matiasmicheletto/CompostGrid/Datasheets/ArduinoUNO.png

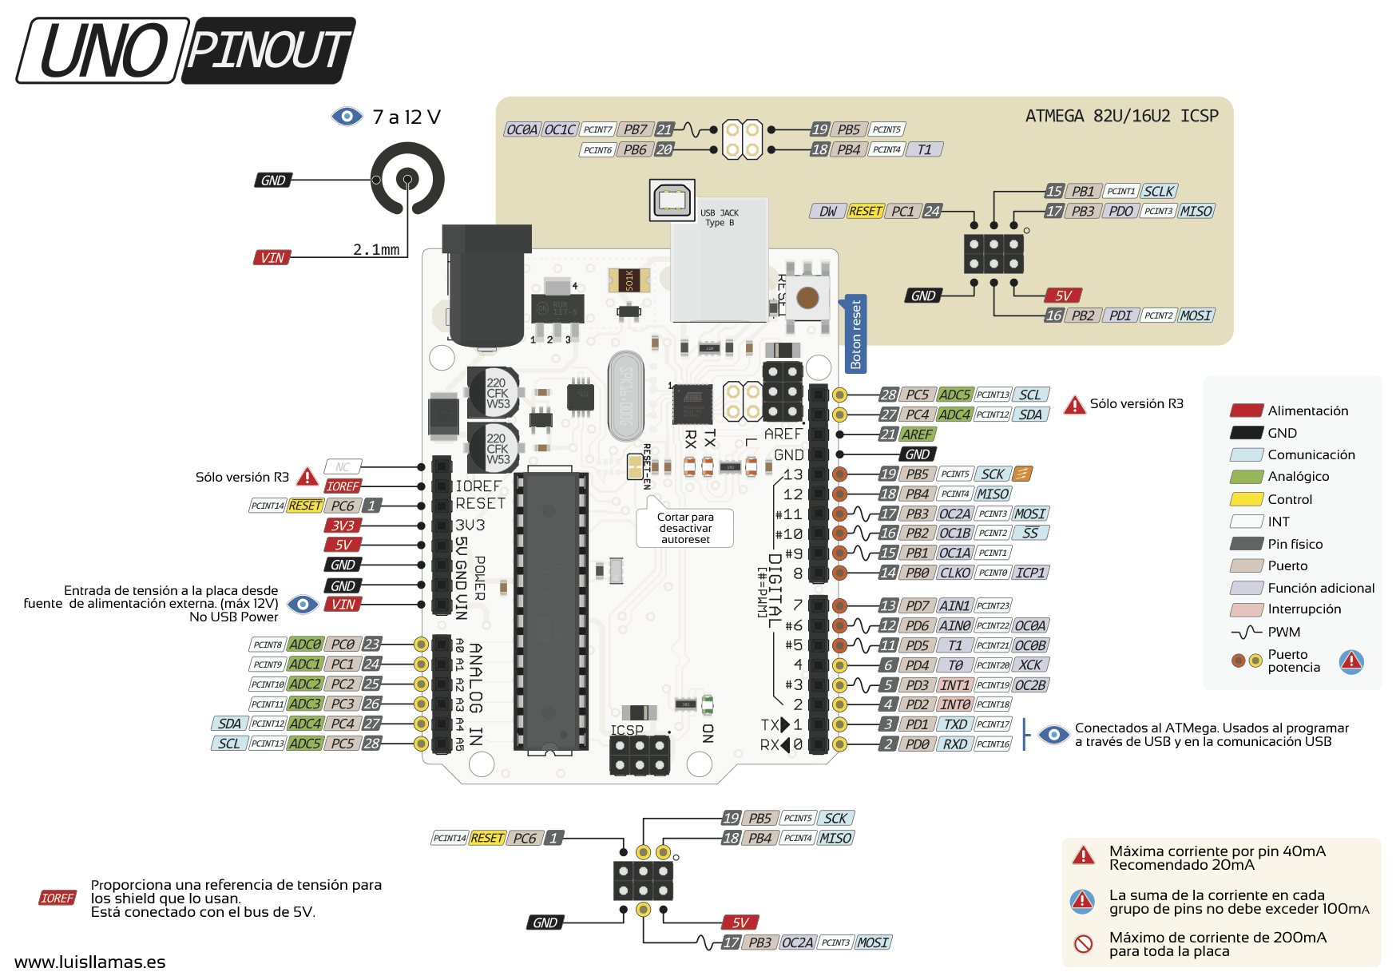
Datasheets/ArduinoUNO.png
