matiasmicheletto/CompostGrid/Hardware/Shield3D.png

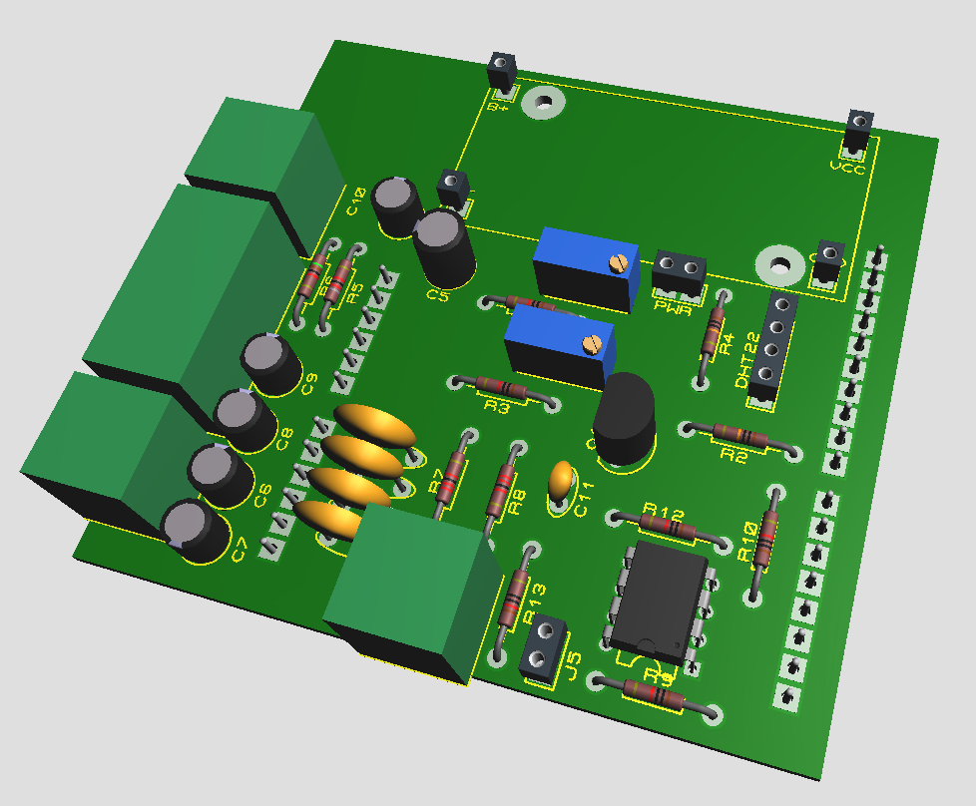
Hardware/Shield3D.png
