matiasmicheletto/CompostGrid/Hardware/Shield.BMP

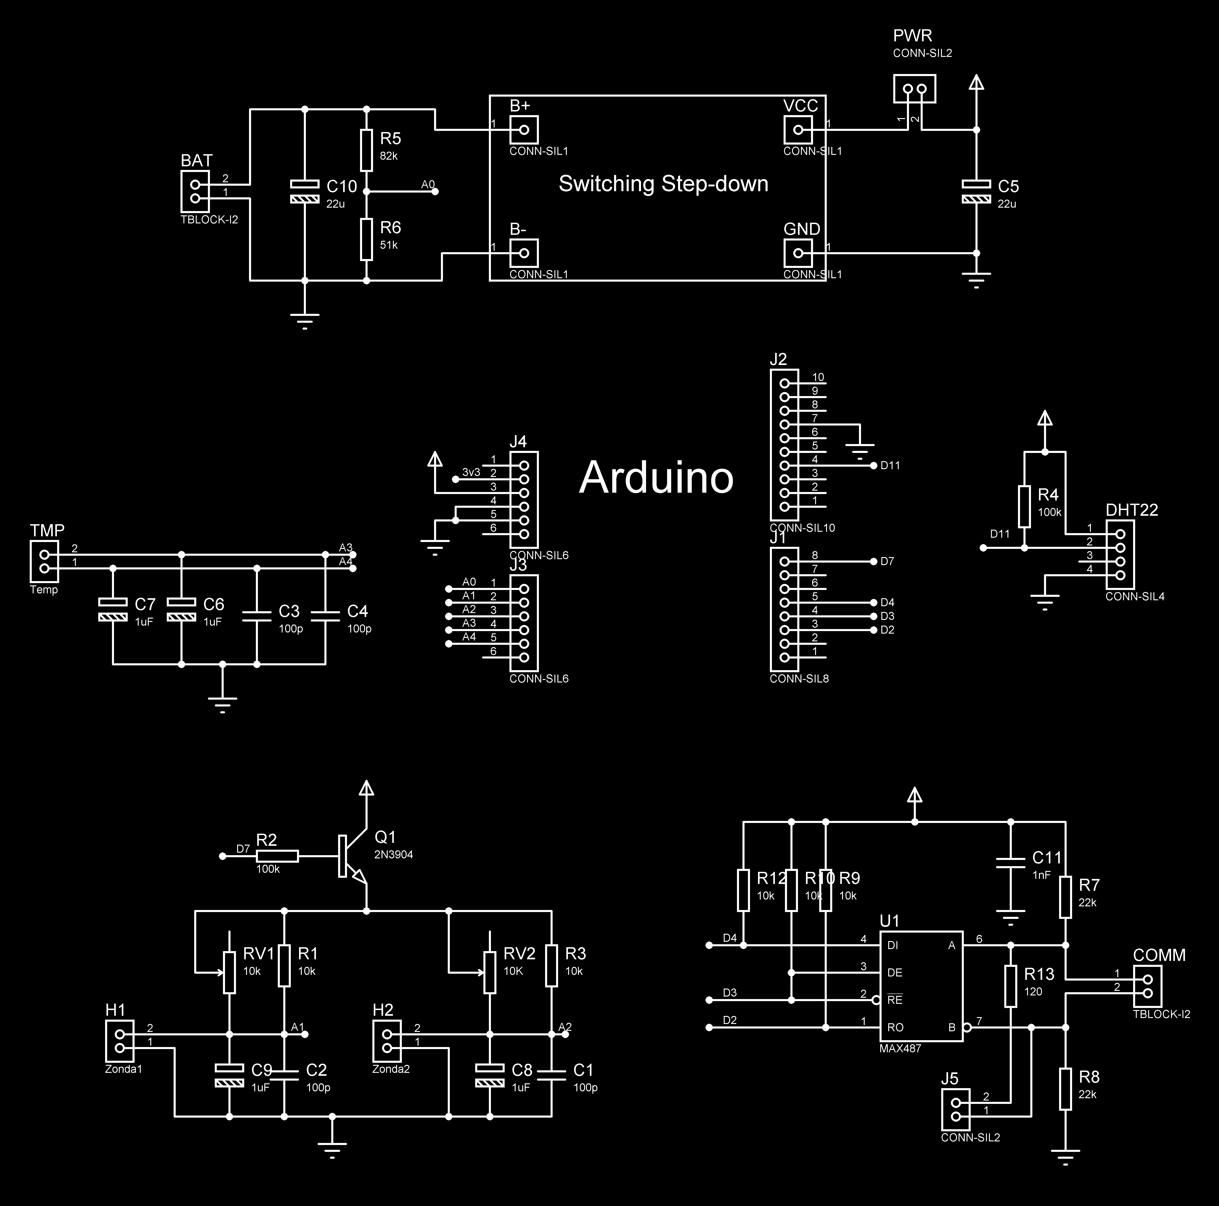
Hardware/Shield.BMP
