matiasmicheletto/CompostGrid/Hardware/Shield_PCB.BMP

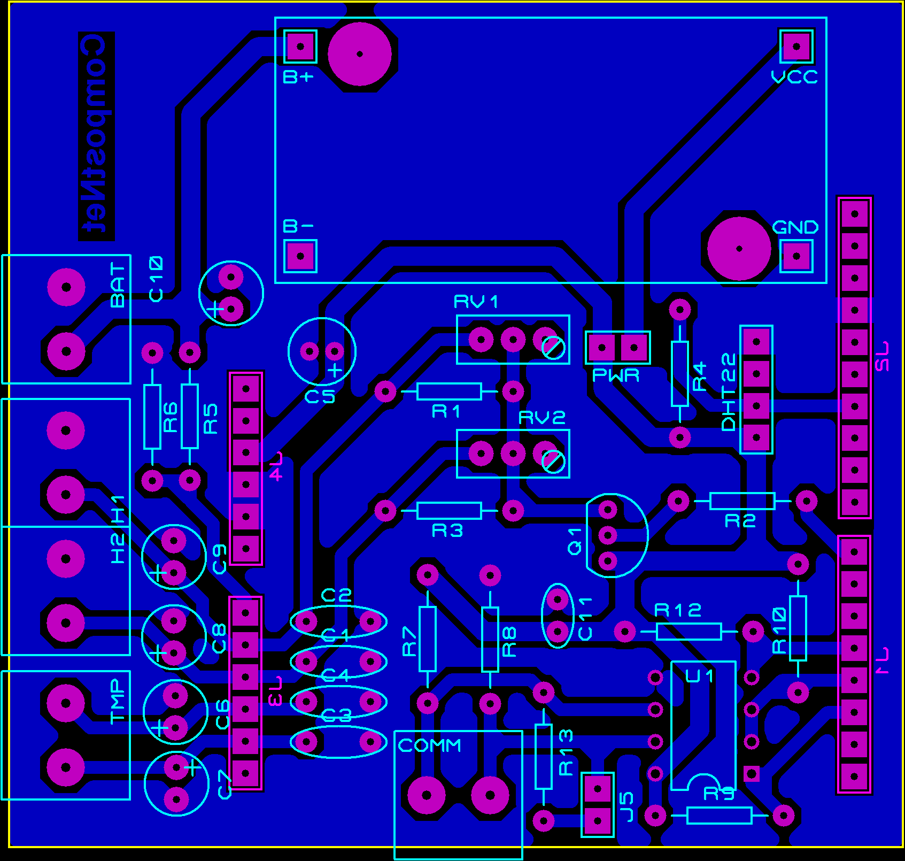
Hardware/Shield_PCB.BMP
