matiasmicheletto/CompostGrid/Img/Proto1.jpg

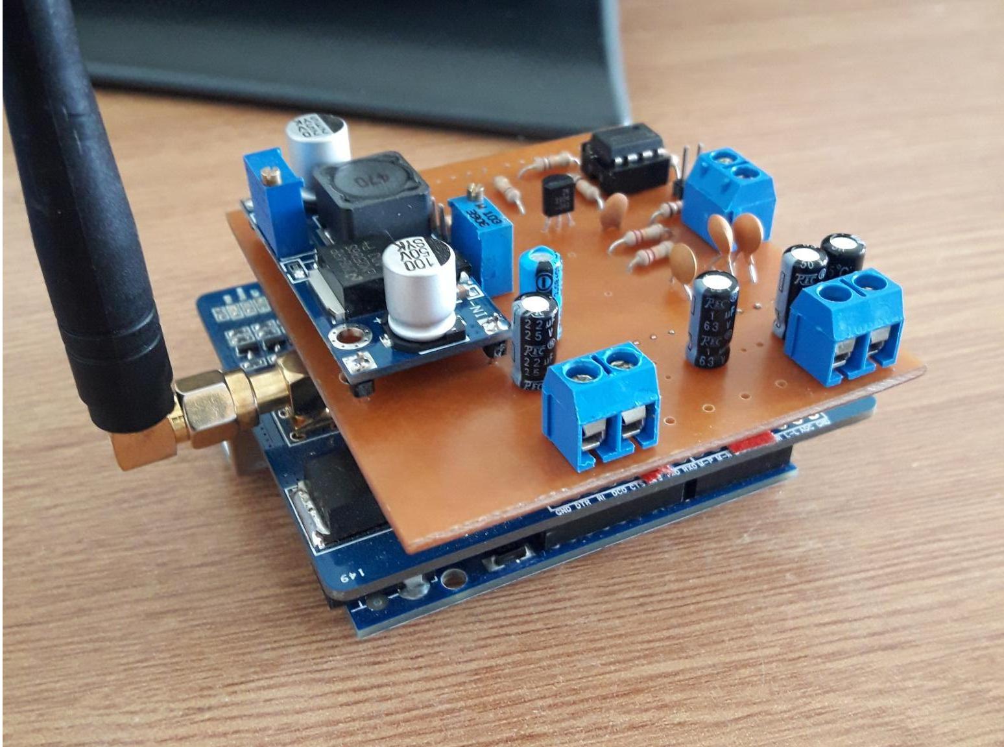
Img/Proto1.jpg
