matiasmicheletto/CompostGrid/Hardware/Componentes.png

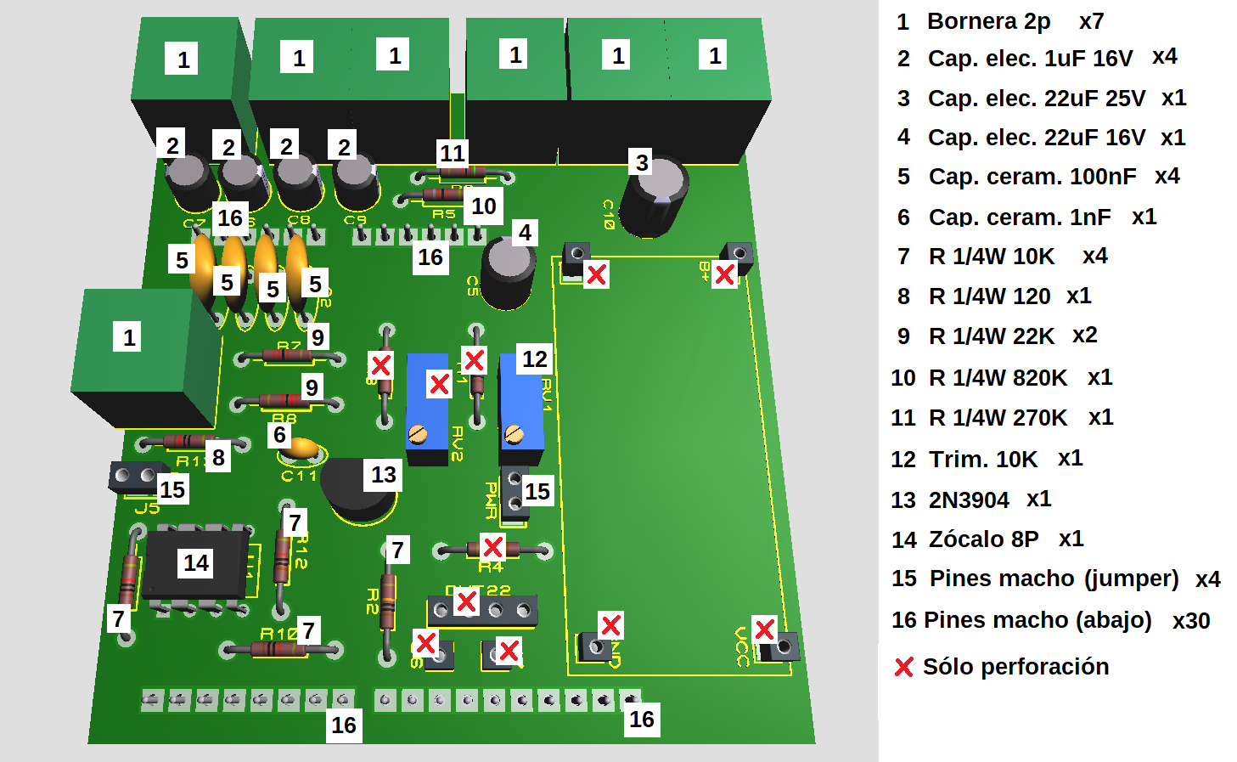
Hardware/Componentes.png
