matiasmicheletto/CompostGrid/Tests/Test_485/20181126_175207.jpg

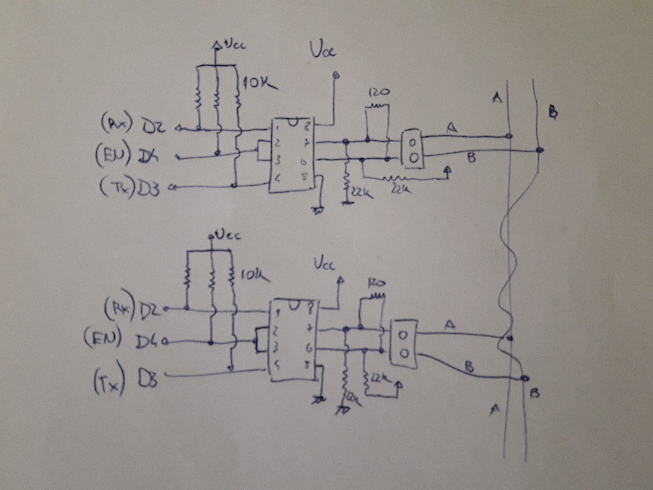
Tests/Test_485/20181126_175207.jpg
