matiasmicheletto/CompostGrid/Hardware/Shield.pdf

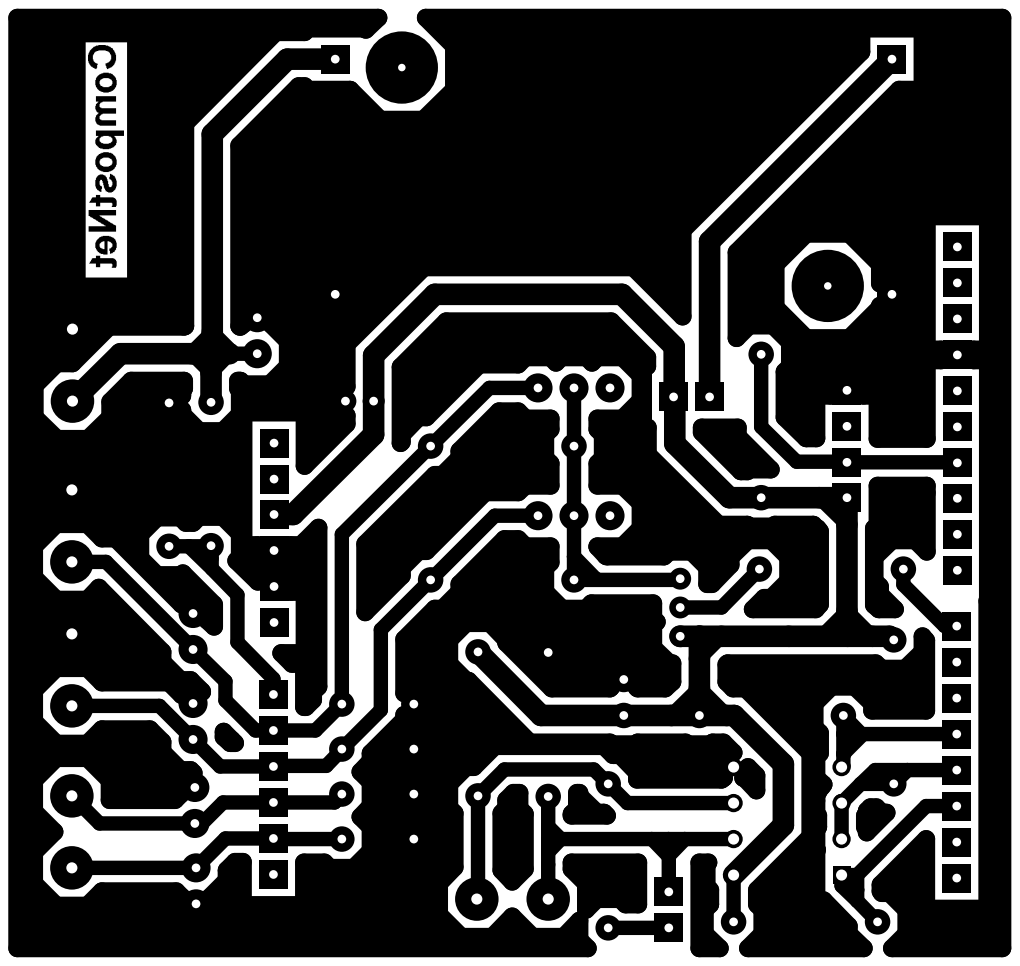
[picture p16: page 1]
