matiasmicheletto/CompostGrid/(list of files, drawings)

Other design files:
Hardware/Shield.pdsprj
